DonovanSquires/KiCadDemoExercise/Exercise.odt

March 20, 2015

Copyright © 2015 Donovan Squires

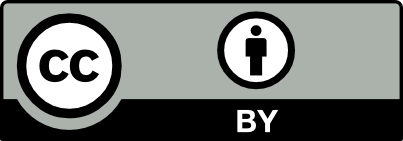
[picture p1: figure]

This work is licensed under a Creative Commons Attribution 4.0 International License (http://creativecommons.org/licenses/by/4.0/).

# Introduction

A design for an Raspberry Pi 3x3x3 LED Cube Shield has been implemented in KiCad. The completed board can be found here:

https://github.com/DonovanSquires/KiCadDemo

The project tries to illustrate several of the concepts common in a KiCad project such as:

- Project folder organization – separating library files, documentation, prints, and fabrication outputs in folders along with the project files
- Multi-sheet hierarchical organization – one root sheet with other sheets represented as hierarchical sheet symbols
- Custom schematic symbols organized in library files
- Adding parameters such as Manufacturer and Supplier part numbers to a schematic symbol to aid in bill of materials (BOM) generation
- Wires – connections between symbols that form a net
- Net labels – implied connections between two or more wires to form a net; net labels only make implied connections on a single sheet
- Ports – implied connections between a wire on a sheet and its corresponding sheet symbol
- Associating schematic symbols with PCB footprints
- Custom PCB footprints organized in library files and folders
- Two-layer PCB design
- Fulfilling predetermined mechanical requirements – lining up connectors and mounting holes of the shield board with the Raspberry Pi
- Fabrication files – generated RS274X Gerber and Excellon Drill files

To become familiar with some of the more difficult concepts in KiCad, this exercise was developed in which the four mounting holes are removed from the completed project. In this exercise you will have to draw a schematic symbol and store it in a library, add the symbols to the schematic, draw the footprint of the mounting hole and store it in a library, synchronize the schematic files with the PCB files, place the mounting hole footprints on the board, and generate fabrication files.

This document and the project files for the exercise may be found here:

https://github.com/DonovanSquires/KiCadDemoExercise

This project and exercise was developed on KiCad (2015-01-16 BZR 5376) on the Windows platform.

# Exercise

## Download and open project files

### Purpose

You will use a set of project files where most of the design has been completed except for the steps that you will perform in this exercise. The project files need to be downloaded and opened in KiCad.

### Background

The project files are stored in a GitHub repository. The repository may be downloaded as a zip file from the website, so no knowledge of git is necessary.

### Procedure

#### Navigate in a web browser to https://github.com/DonovanSquires/KiCadDemoExcercise

#### Click on the link to download a zip file of the repository

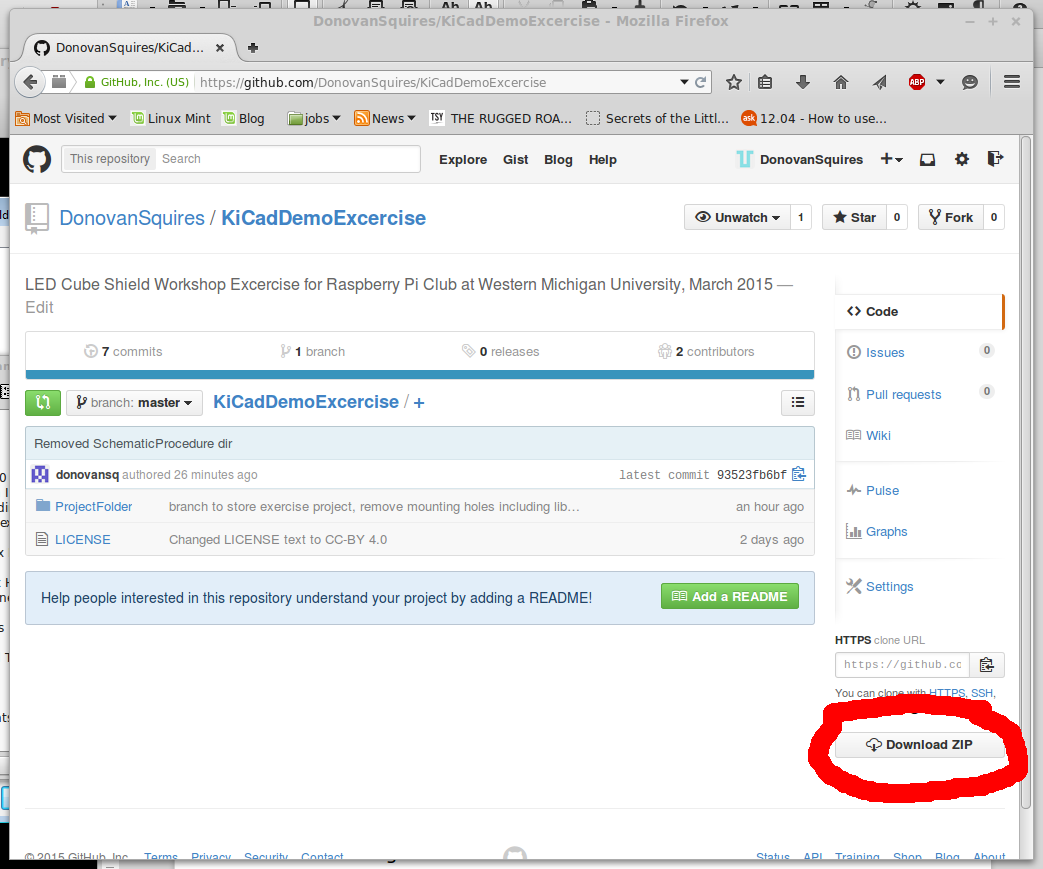
[picture p2: figure]

#### Unzip the downloaded file

#### Run KiCad and open the project file ProjectFolder\KiCadDemo.pro

## Create new schematic library

### Purpose

Create a symbol to represent a mechanical mounting hole. This symbol will be associated with a footprint that will KiCad to automatically add to the PCB.

### Background

Reusable schematic elements are store in plain text “*.lib” files. Multiple symbols may be stored in a single library file, but I prefer to make a separate library file for each symbol.

Here we will create a symbol representing a single hole that can be placed on the board and is often not electrically connected to the circuit (but it may be in some cases). Placing a symbol on the schematic allows the mounting holes to be tracked.

Pins added to symbols are used to represent an electrical connection. The schematic design rule check (DRC) can enforce rules such as not connecting two outputs to one net. I often set the pins as “Passive”, though, to avoid DRC errors that are not really applicable to the schematic.

### Procedure

#### Open Schematic Library Editor

#### Click “Create New Component” icon

#### Fill out component information

Component name: Mounting_Hole

Default reference designator: M

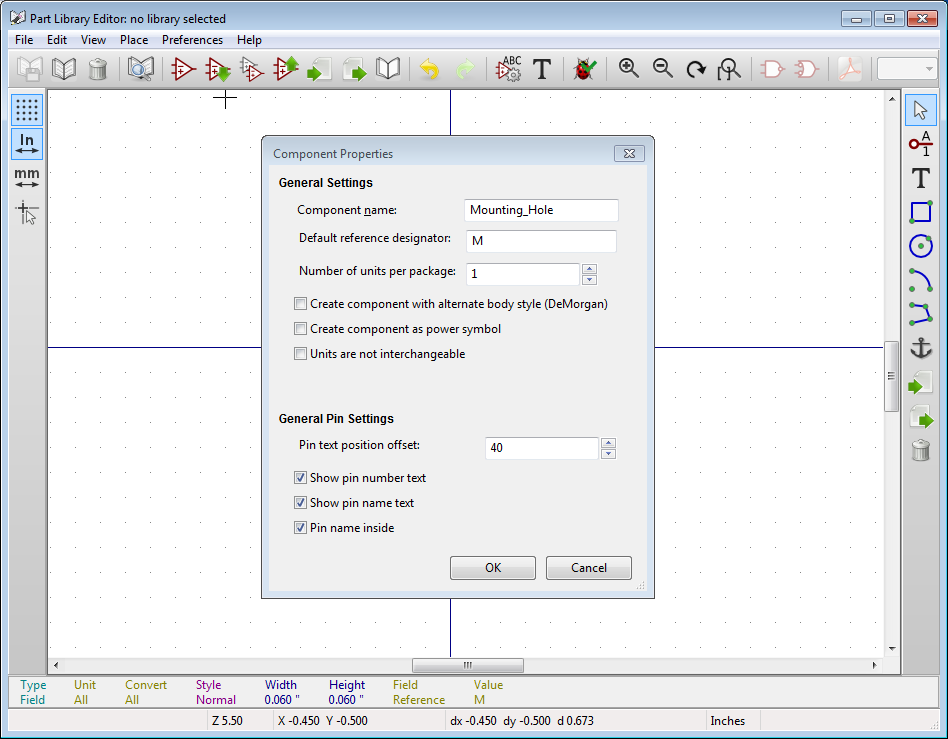
[picture p3: figure]

#### Draw symbol graphics

Draw a circle with a radius of 0.15”

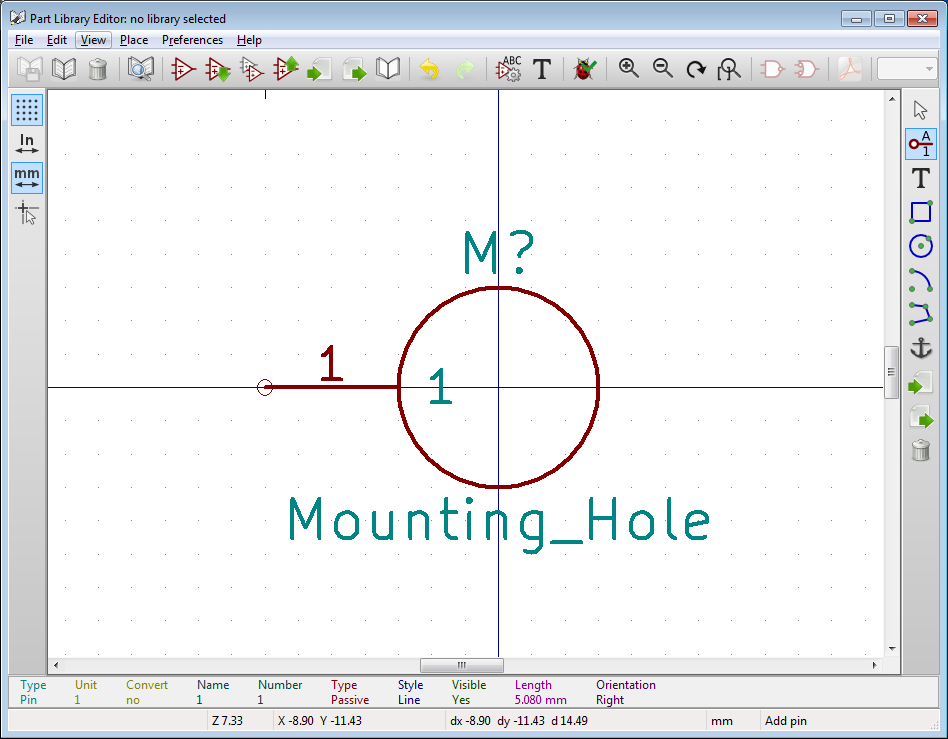
[picture p4: figure]

#### Add pin

This will allow the pad of the mounting hole to be electrically connected to the rest of the circuit if desired. Make sure that “Electrical Type” is “Passive”

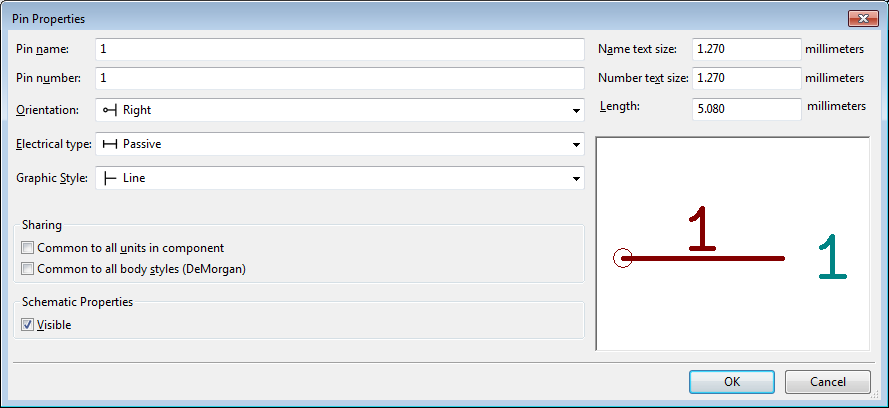
[picture p5: figure]

#### Click “Save component to new library” icon

#### Save “mounting_hole.lib” in project “lib” directory

#### Add library to project

Click “Preferences”->”Set Active Libraries”

Click “Add”

Add “lib/mounting_hole.lib”

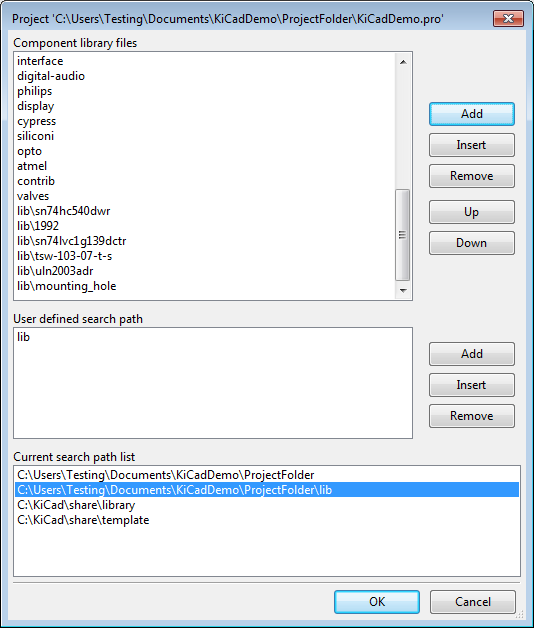
[picture p6: figure]

#### Close Schematic Library Editor

## Add components to schematic

### Purpose

Add four mounting holes symbols to the schematic that will later be associated with our desired mounting hole footprint. The schematic netlist will be updated to allow the other programs in the toolchain to read the updates to the schematic.

### Background

Components can be added from libraries. Connections can be drawn between component pins, but the mounting hole we are using will not be electrically connected on this board.

### Procedure

#### Open Eeschema

#### On the root sheet, click “Place”->”Component”

#### Click on the schematic

#### Choose “Mounting_Hole”

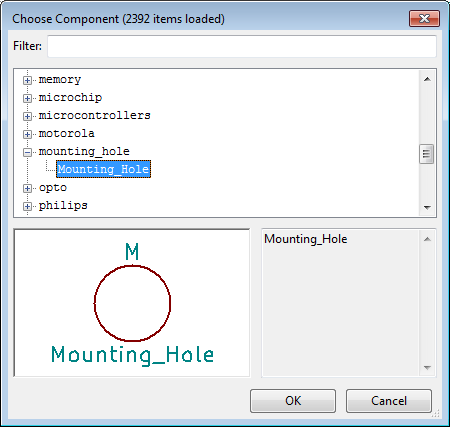
[picture p7: figure]

#### Place symbol on schematic

#### Add three more mounting hole components

You may click on the schematic again to bring up the select component dialog, or you may copy and paste the first symbol by hovering over it and pressing “c”.

#### Click “Place”->”No Connect Flag” and add flags to pins

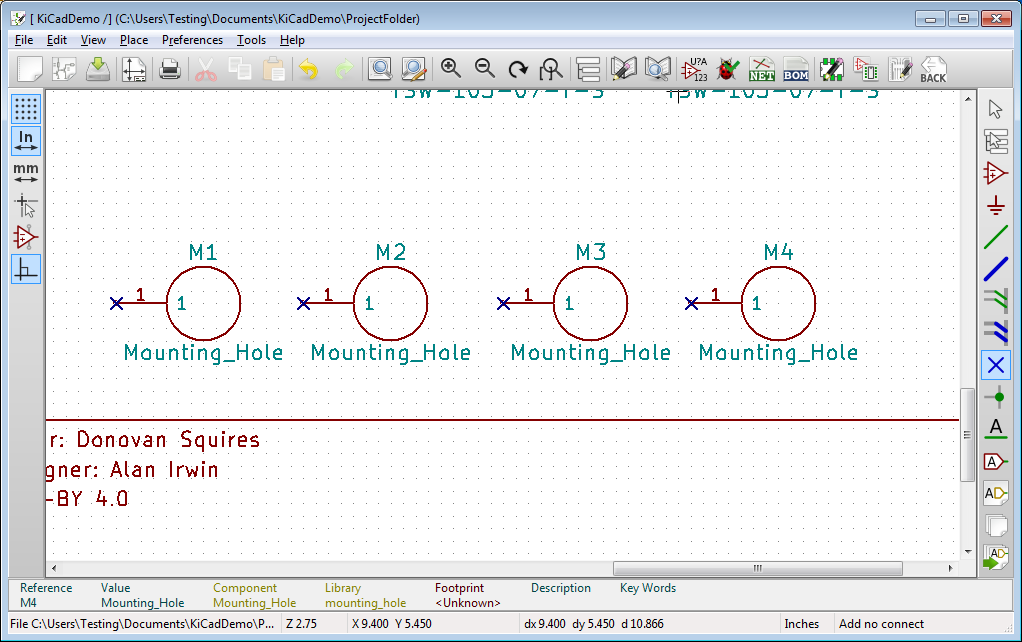
[picture p8: figure]

#### Click “Tools”->”Annotate Schematic”

This will replace the reference designators “M?” with unique numbers: “M1”. “M2”, etc. Make sure “Keep existing annotation” is selected to ensure that previously assigned designators are not re-assigned with a different number.

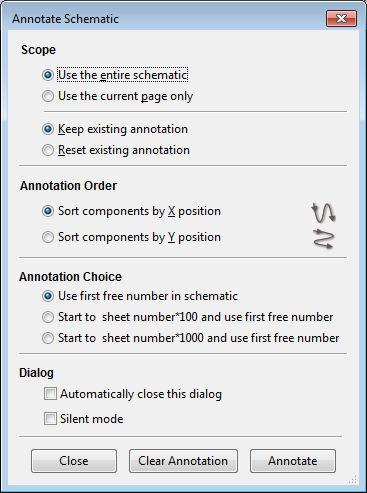
[picture p9: figure]
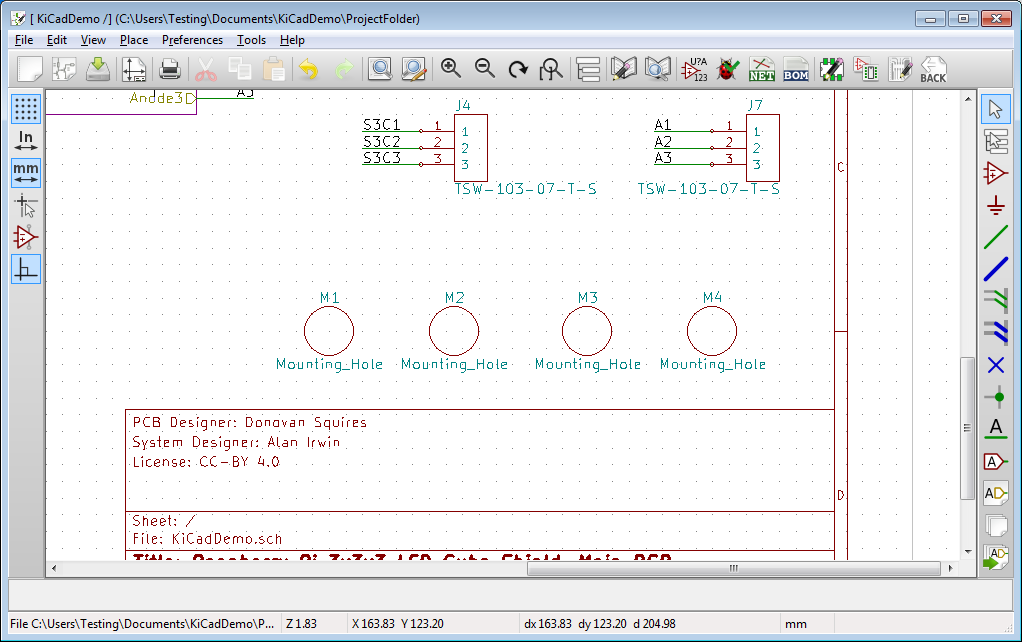
[picture p10: figure]

#### Click “Tools”->”Generate Netlist File”

In “Pcbnew” tab, click “Generate”, and overwrite the existing netlist file.

## Create new PCB footprint

### Purpose

Create a new PCB footprint library, make it accessible to Pcbnew, and create a mounting hole footprint.

### Background

A new style KiCad footprint library is a folder named “<library name>.Pretty” containing PCB footprint files “*.mod” (and 3D models and simulation models).

Pcbnew and the footprint editor need to be made aware of library locations before a footprint may be used or saved to the library. Adding to the list of available libraries is complicated. The following link explains some of the current challenges with library management: http://diy-scib.org/blog/working-kicads-terrible-library-management

This is the workflow I prefer, at the moment, for creating PCB libraires.

### Procedure

#### Create folder for PCB footprints

Using the OS's file manager, create folder “mounting_hole.Pretty” under “ProjectFolder/lib”.

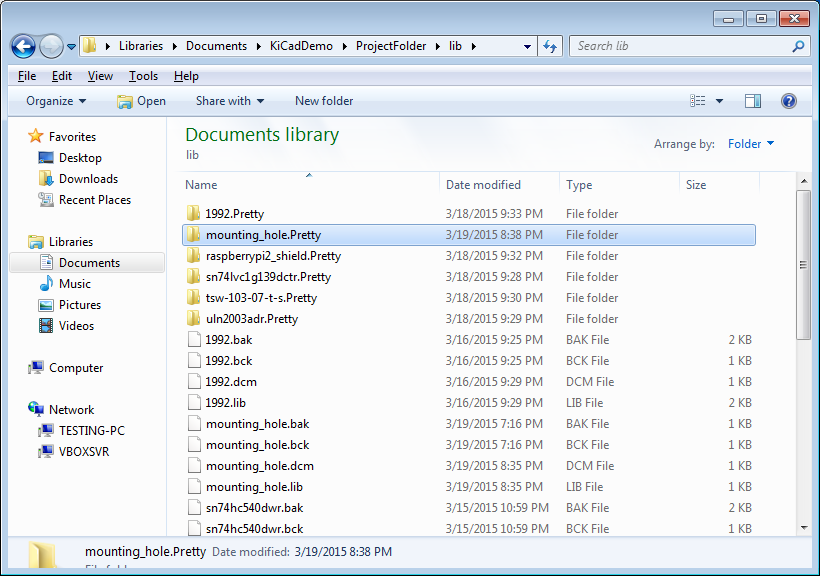
[picture p11: figure]

#### Open Pcbnew

#### Click “Preferences”->”Library Tables”

#### Add reference to PCB library

Select tab “Project Specific Libraries”, click “Append Library”, and fill out table as shown in the screenshot.

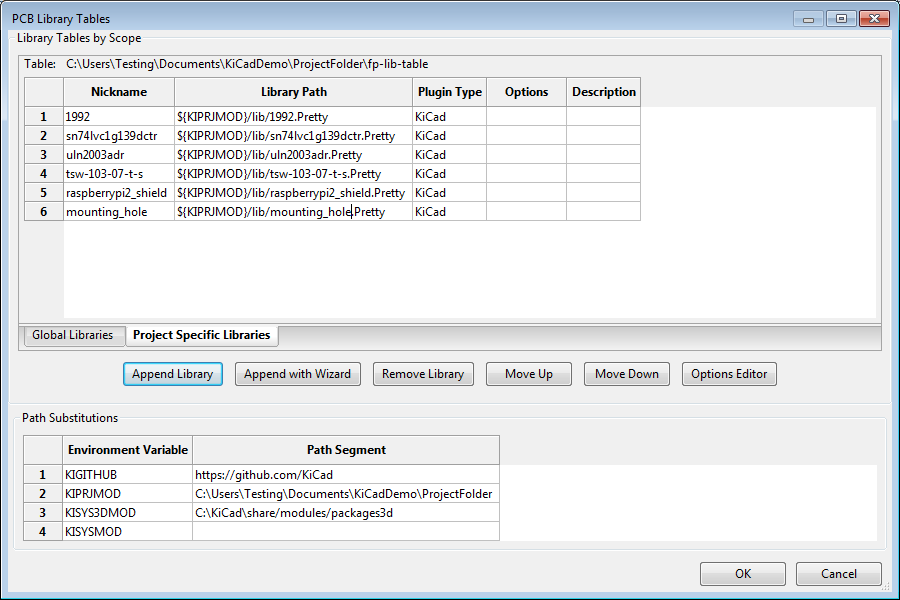
[picture p12: figure]

#### Open Footprint Editor

#### Click “Select Active Library” icon

#### Select the “mounting_hole” library (same as the nickname field from 2.4.3.4

#### Click “File”->”New Footprint”

Enter footpring name: “mounting_hole_2.75mm_pth”

pth – Plated Thru-Hole, a copper plated (mounting) hole with a copper annular ring

npth – Non-Plated Tru-Hole, an unplated (mounting) hole

#### Press “e” on text to edit “Value (VAL**)” field

Set “Display” to “Invisible”

This field, if visible, will place the text in the “Value” parameter field of the schematic symbol on the silkscreen of the board. The silkscreen can get crowded on boards, and the “Reference” text is more important: it will be replaced with the reference designator of the component.

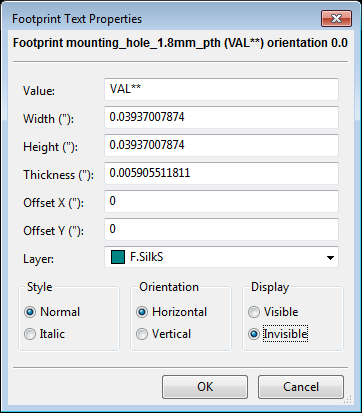
[picture p13: figure]

#### Ensure that “mm” is the selected unit

Icon is along the left side of the screen. This will let us define the pad in metric units

#### Click “Place”->”Pad”

#### Click on grid location (0,0) to place pad at origin

#### Hover over pad with cursor and press “e” to edit pad parameters

Set “Pad type” to “Through-hole” and “Circular” ans set “Size” to 4.75mm

Set “Drill” to “Circular” and 2.75mm (same diameter as mounting hole on Raspberry Pi B+/2)

Set “Pad number” to 1, this should correspond to the “Pin number” seen in section 2.2.3.5

#### Click “File”->”Save Footprint in Active Library”

#### Close footprint editor

## Associate footprint with schematic symbol

### Purpose

Tell KiCad that you want the footprint we created associated with each instance of the symbols we added to the schematic.

### Background

KiCad allows you to select a different footprint for each symbol in the schematic. This gives you flexibility in using different footprints for the same symbol. For instance, if you have a USB connector with 4 pins and a 0.1” pin header with 4 pins, you can use the same schematic symbol for both parts, but you can select the different footprints for the two components on the schematic. The program that assigns footprints is called Cvpcb.

### Procedure

#### In Schematic Editor, click “Tools”->”Assign Component Footprint”

#### Assign “mounting_hole:mounting_hole_2.75mm_pth” footprint to components M1 to M4

In the left pane, select the footprint library. In the middle plane, select one of the components from the schematic. In the right pane, double-click the name of the footprint you want to assign to the component.

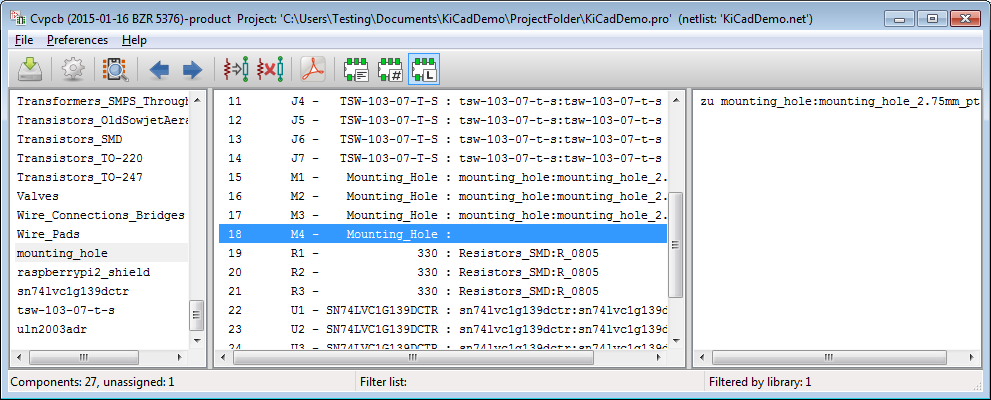
[picture p14: figure]

#### Click “File”->”Save Component File”

#### Close Cvpcb

## Import netlist in Pcbnew

### Purpose

Import the changes from the schematic editor to synchronize the components and connections

### Background

Pcbnew will ensure that all of the symbols in the schematic have their associated components on the board, and Pcbnew will keep track of which pins need to be electrically connected or not connected, according to the schematic drawing.

When you make any changes to the schematic, the changes must be imported into Pcbnew.

### Procedure

#### In Pcbnew, click “Tools”->”Netlist”

#### Click “Read Current Netlist” and “Rebuild Board Connectivity”

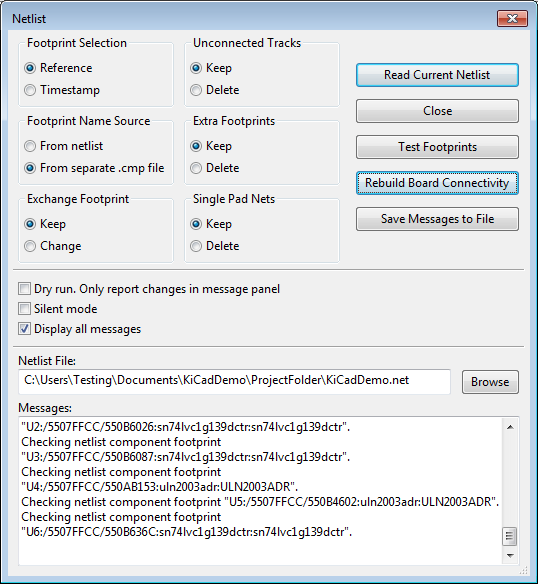
[picture p15: figure]

#### Notice the mounting holes are placed in the PCB editor, but they are all placed at the same location, on top of each other

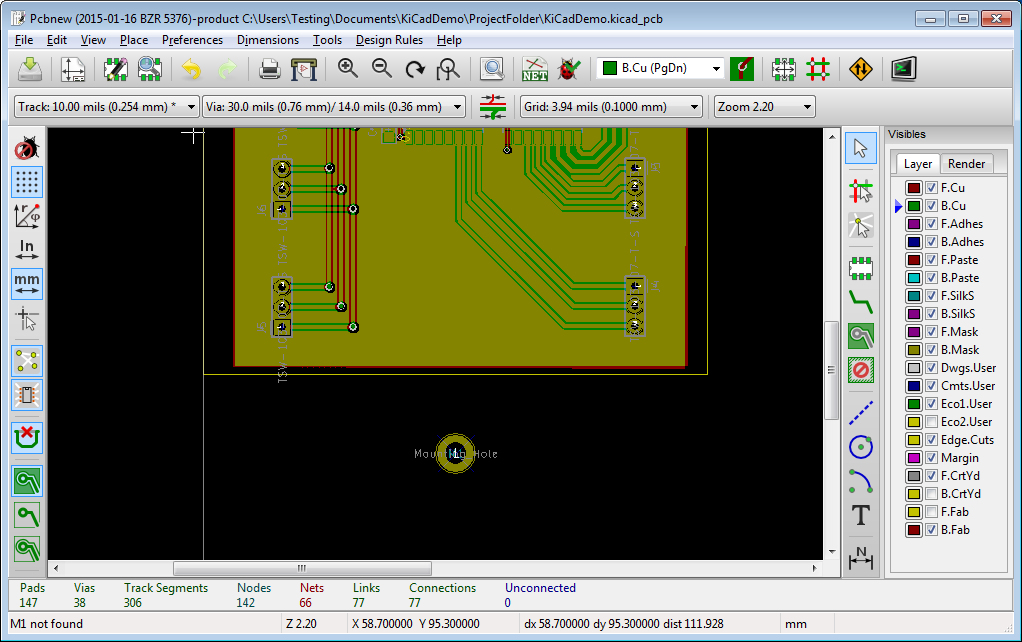
[picture p16: figure]

## Place components

### Purpose

The imported changes from the schematic are not placed intelligently. Components need to be moved so they are not on top of each other, and they need to be placed in the required location on the board.

### Background

Pcbnew can move the components so they are easier to grab and move. We will have to place the mounting holes in the location that we need, which will correspond to the mounting hole locations on the Raspberry Pi B+/2

### Procedure

#### In Pcbnew, set zones to “do not show filled zones”

This will make the board easier to see.

#### Click the “Mode footprint: [...]” icon

This will make the options we need available in the right-click menu.

#### Right-click anywhere on the board

#### Select “Global Spread and Place”->”Spread out footprints not already on board”

If this was a new board, you can select “Spread out all footprints”

Result:

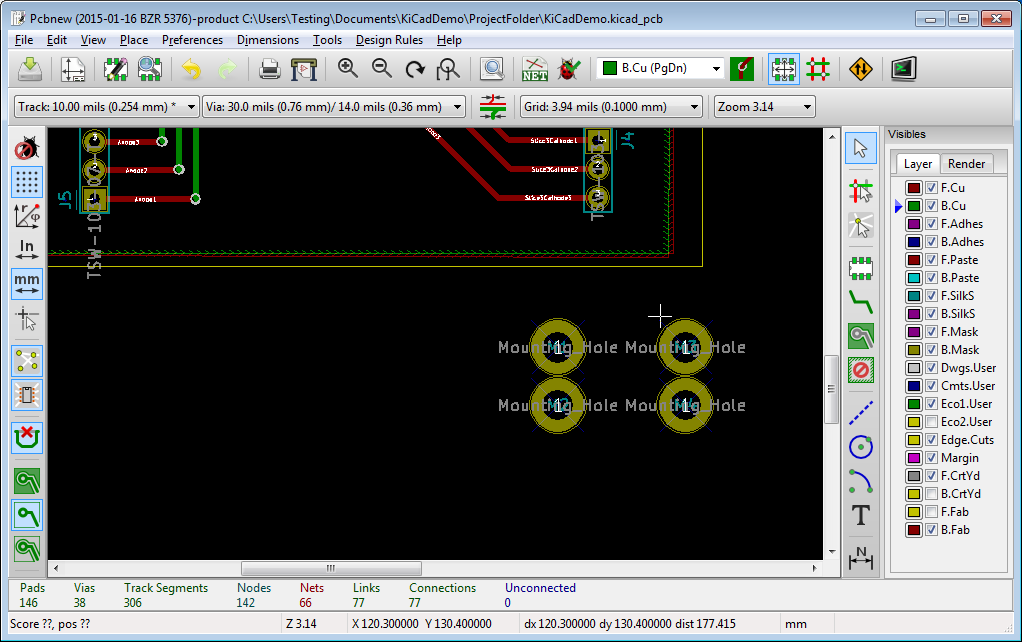
[picture p17: figure]

#### Enable visibility on F.Fab layer

I placed a schematic footprint that uses this layer to draw an outline of the Raspberry Pi with its connector and mounting holes.

#### Place mounting holes at the same locations as the Pi holes

You can try to place them manually, or you can press “e” over the footprint and type the “X” and “Y” position for a more accurate result

#### Right-click on edge of zones on front and bottom copper

For each zone, select “Zone Outline”->”Zones”->”Fill Zone”.

This makes the zone not intersect with the new component.

Zones are a.k.a. copper pours or copper planes or regions in other CAD packages.

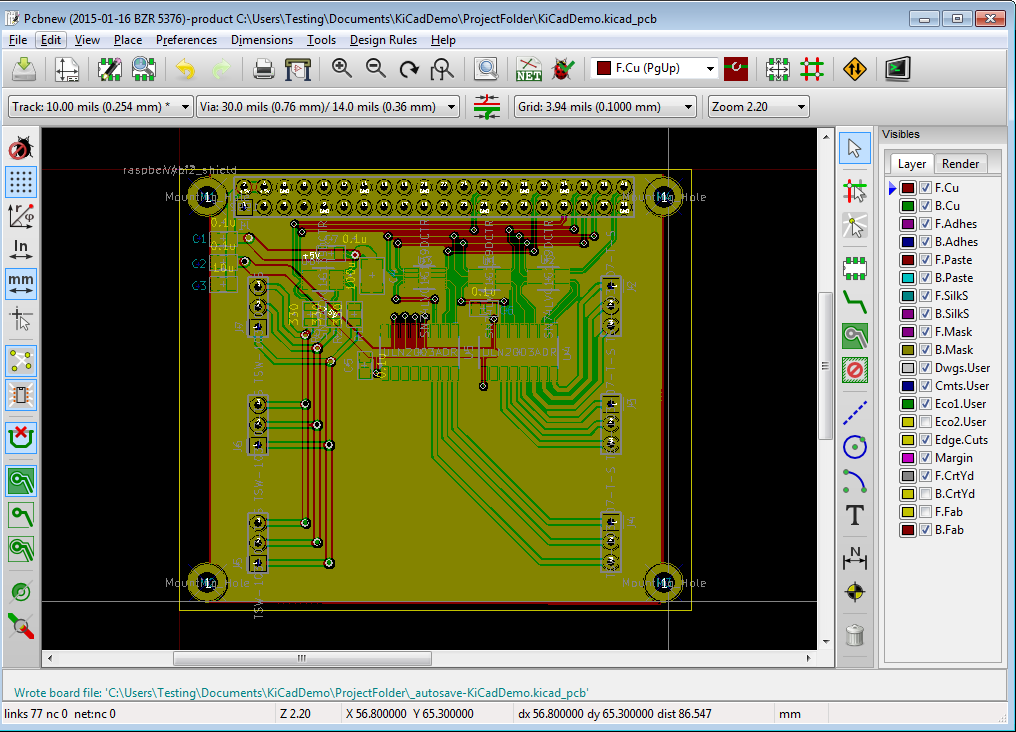
[picture p18: figure]

#### Select “Tools”->”DRC”

#### Click “Start DRC” then “List Unconnected”

This will check to make sure that pads and nets aren't connected in a way that conflicts with the netlist.

## Generate Gerbers

### Purpose

Produce fabrication files for a board manufacturer

### Background

Most manufacturers accept a standard text format for defining the board. Gerber RS-274X is the most common standard, which KiCad outputs by default when you select a Gerber output. To define the drill holes, Excellon Drill files are the standard most used.

Each layer and the drill file are stored in separate files.

This version of KiCad (2015-01-16 BZR 5376) appears to only output Gerbers in metric format, whereas, most manufacturers specify imperial format (inches). The Excellon Drill file should probably be output as metric to be consistent with the Gerber files.

### Procedure

#### In Pcbnew, click “File”->”Plot”

#### Fill out the window as below and click “Plot”

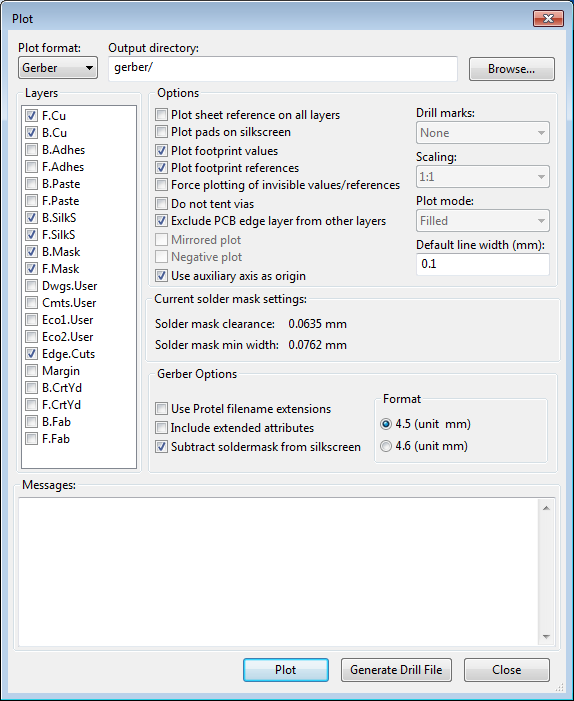
[picture p19: figure]

#### In the “Plot” window, select “Generate Drill File”

#### Fill out the window as below and click “Drill File”

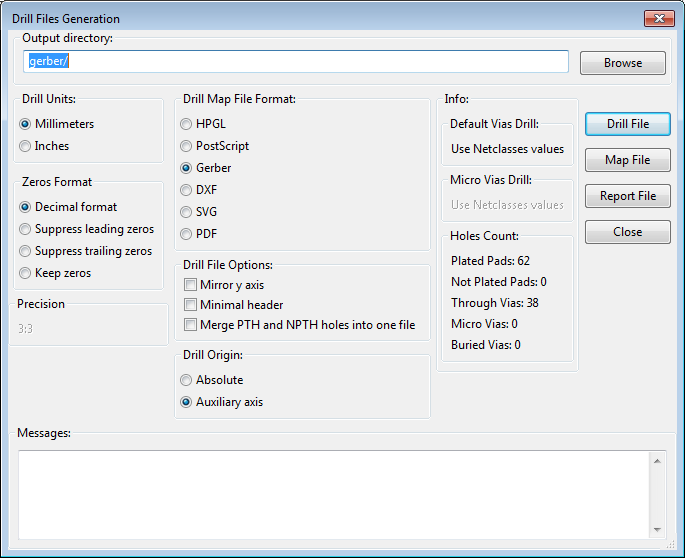
[picture p20: figure]

#### Fabrication files have been created

You can close windows and exit KiCad. It's good to verify the gerber files are what you expect with a gerber viewer, such as the one included in KiCad or a 3rd party software.

# Appendix

## User trace and via bug

When you open a PCB file, the user made track widths and via sizes will not be available. Open the “Design Rules”->”Design Rules” dialog, and the user tracks and vias will be available again.

Copyright © 2015 Donovan Squires
