DonovanSquires/KiCadDemoExercise/ProjectFolder/print/KiCadDemoSchematic.pdf

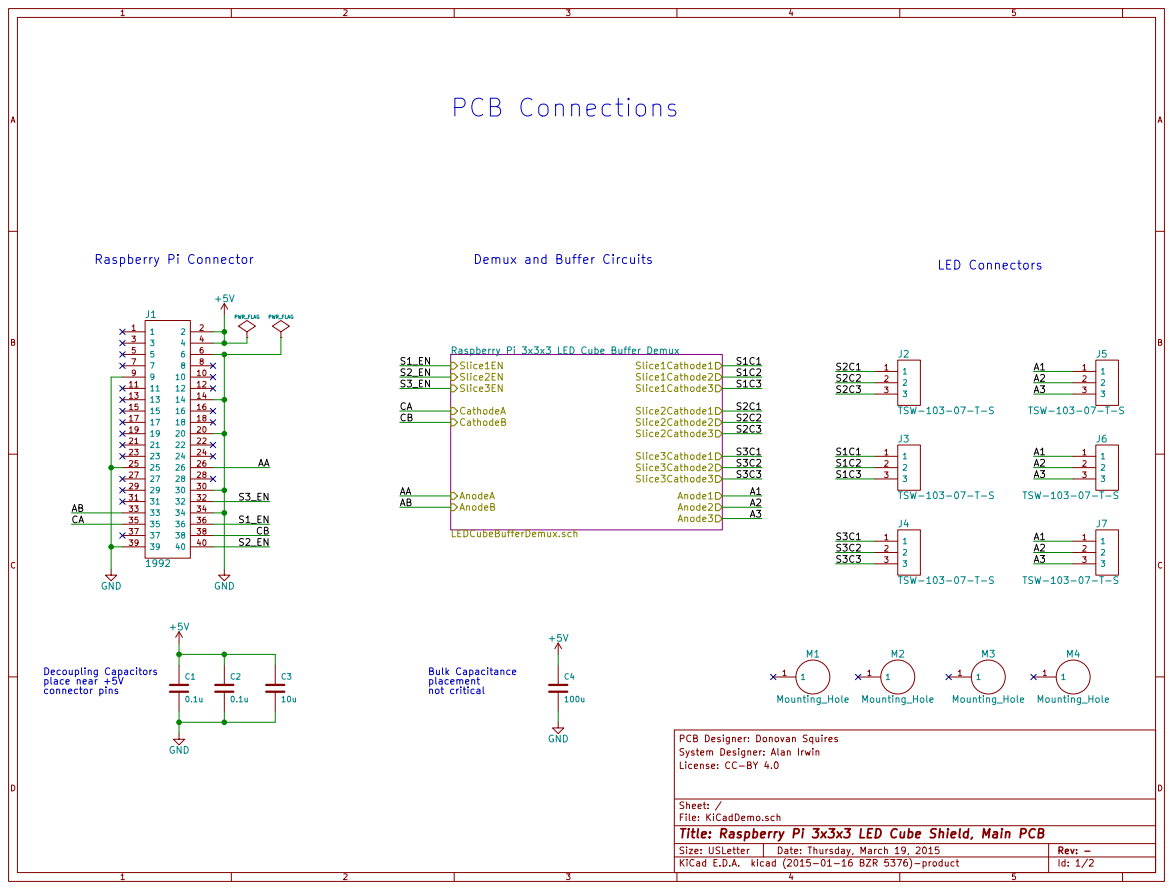
[picture p21: page 1]

PCB Designer: Donovan Squires
File: KiCadDemo.sch Sheet: / License: CC-BY 4.0 System Designer: Alan Irwin

Id: 1/2 Title: Raspberry Pi 3x3x3 LED Cube Shield, Main PCB

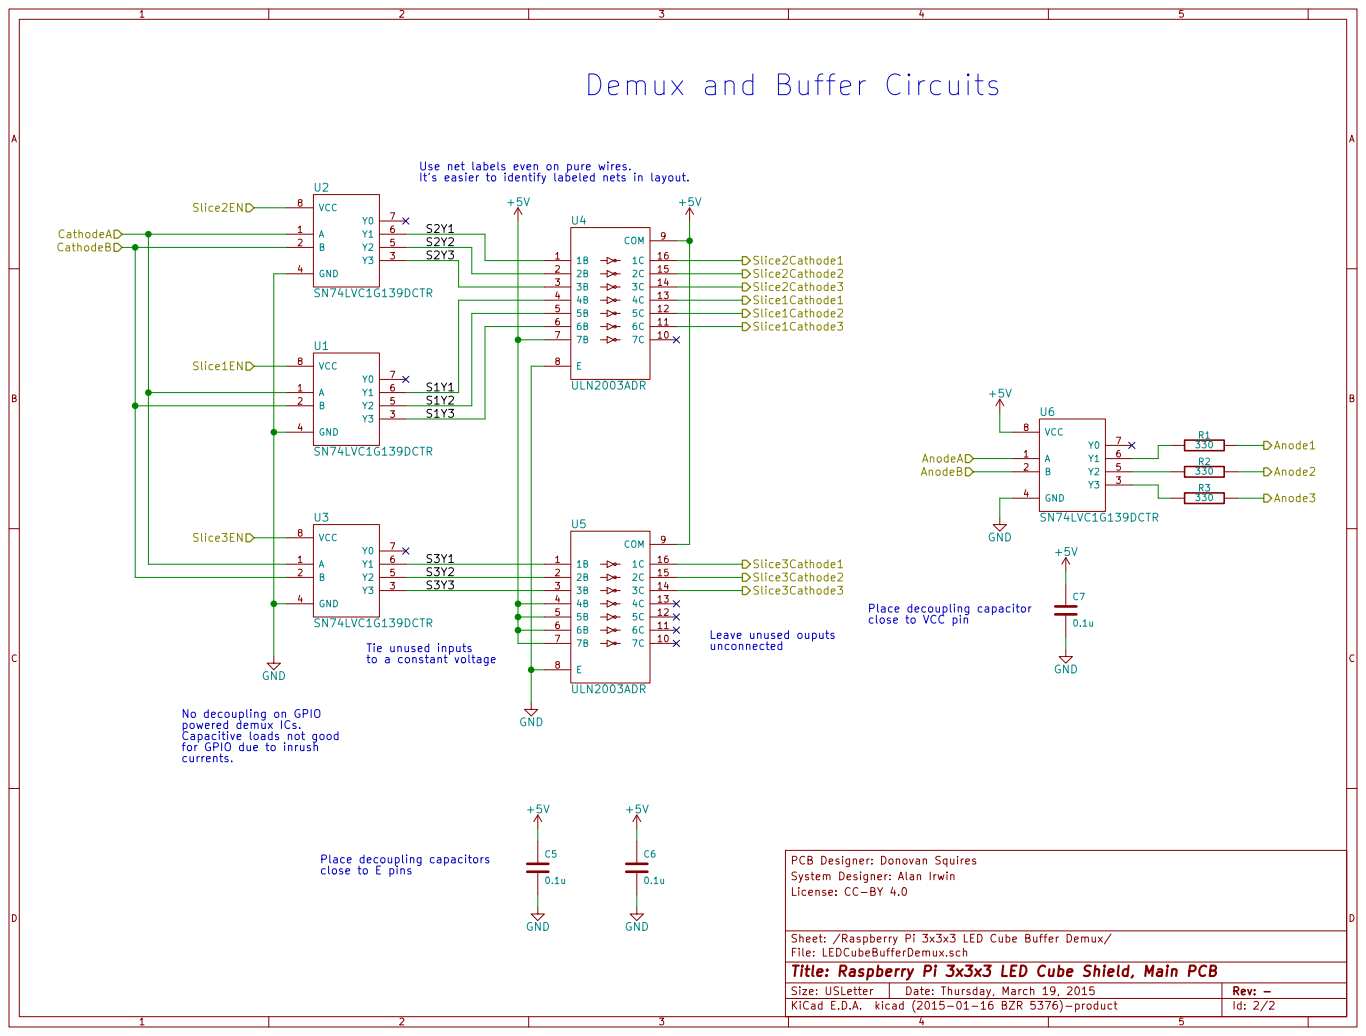
[picture p22: page 2]

Demux and Buffer Circuits

Use net labels even on pure wires.
It's easier to identify labeled nets in layout.

5B 5
6B 6

S3Y2 | 2B 2
S3Y3 | 3B 3

4B 4

Place decoupling capacitor
close to VCC pin

No decoupling on GPIO
powered demux ICs.
Capacitive loads not good
for GPIO due to inrush
currents.

PCB Designer: Donovan Squires
File: LEDCubeBufferDemux.sch Sheet: /Raspberry Pi 3x3x3 LED Cube Buffer Demux/ License: CC-BY 4.0 System Designer: Alan Irwin

Id: 2/2 Title: Raspberry Pi 3x3x3 LED Cube Shield, Main PCB
