DonovanSquires/KiCadDemoExercise/ProjectFolder/doc/raspberry-pi-3x3x3-led-cube-shield.pdf

# Cathode/Ground Control

# Anode/VCC Control

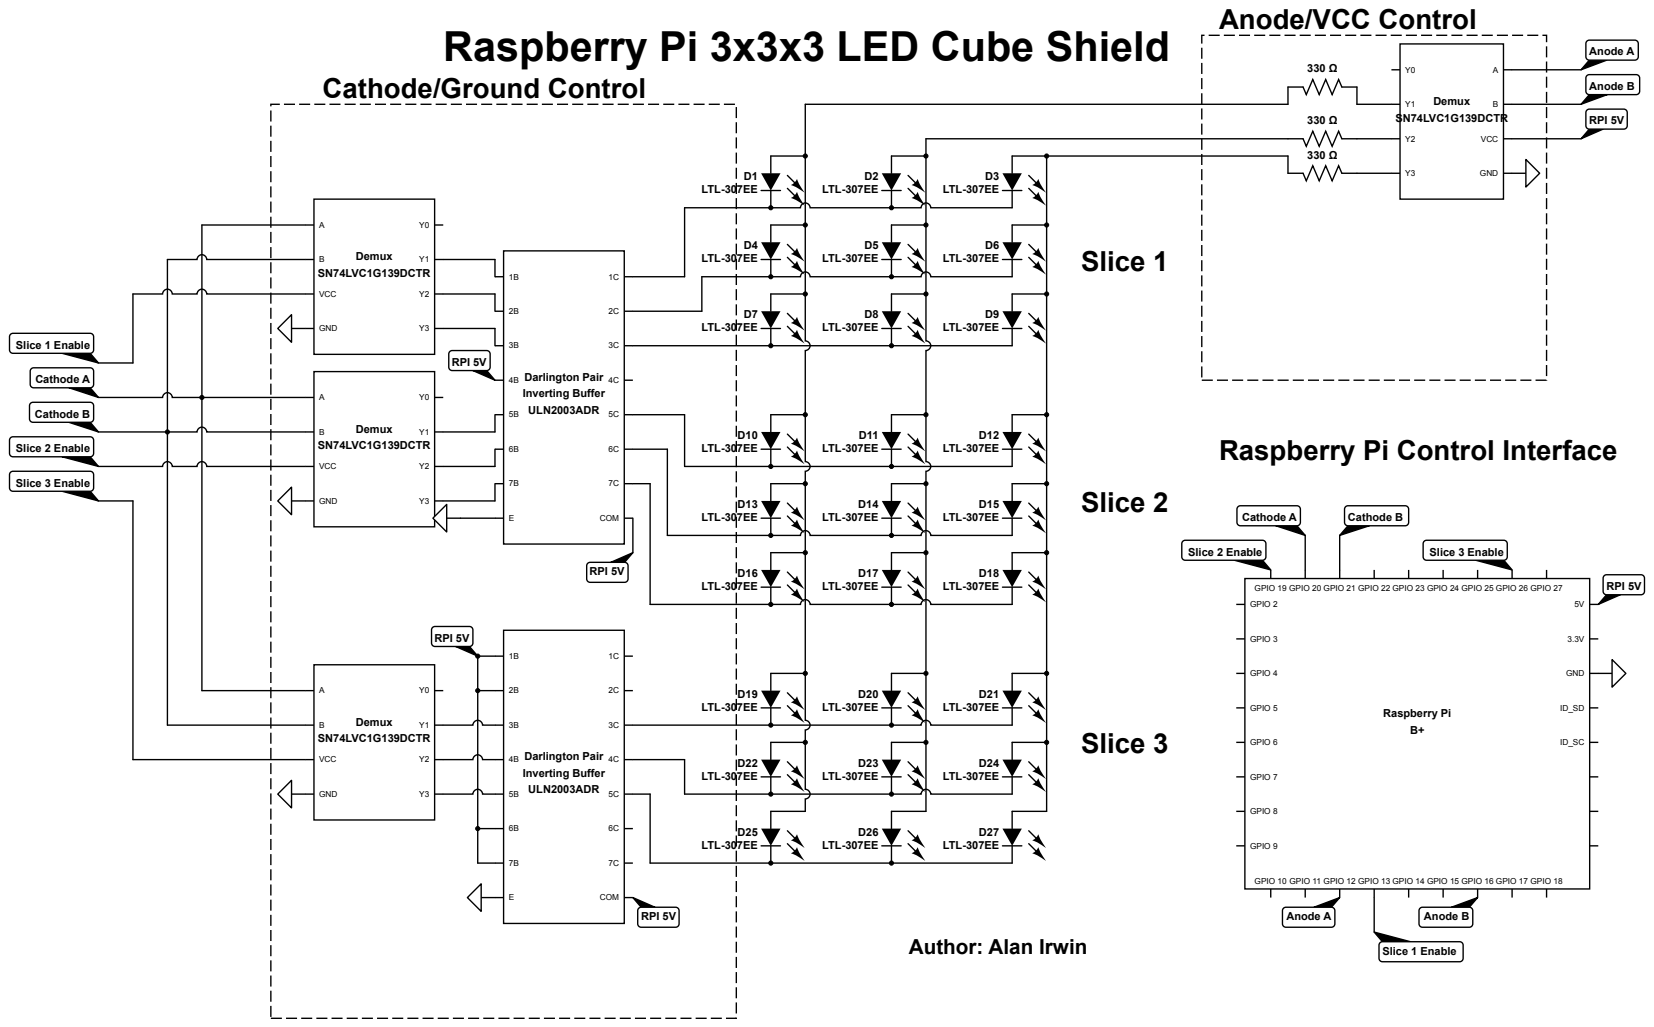
[picture p23: page 1]

Raspberry Pi 3x3x3 LED Cube Shield

Raspberry Pi Control Interface

GPIO 19 GPIO 20 GPIO 21 GPIO 22 GPIO 23 GPIO 24 GPIO 25 GPIO 26 GPIO 27

GPIO 10 GPIO 11 GPIO 12 GPIO 13 GPIO 14 GPIO 15 GPIO 16 GPIO 17 GPIO 18
