DonovanSquires/KiCadDemoExercise/ProjectFolder/print/KiCadDemoPCB.pdf

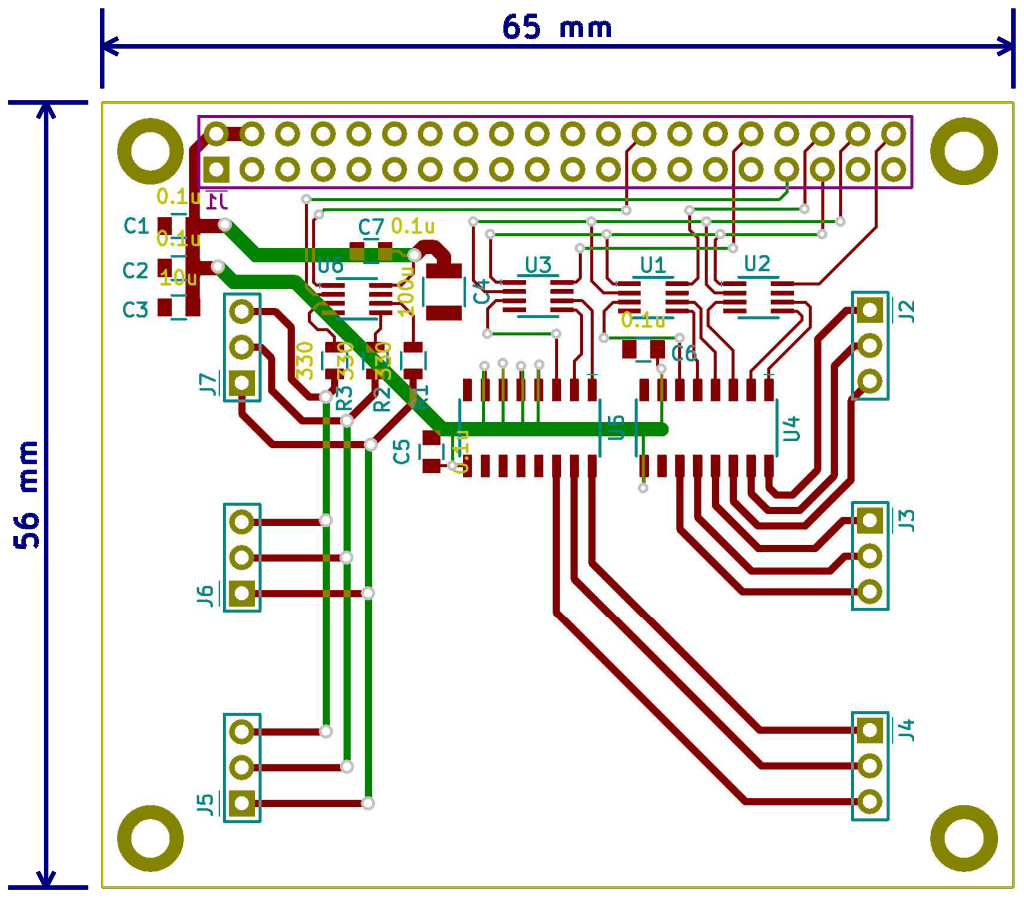
[picture p24: page 1]
