DonovanSquires/KiCadDemoExercise/ProjectFolder/KiCadDemo.kicad_pcb

## KiCad design ProjectFolder/KiCadDemo.kicad_pcb (2015-03-20)

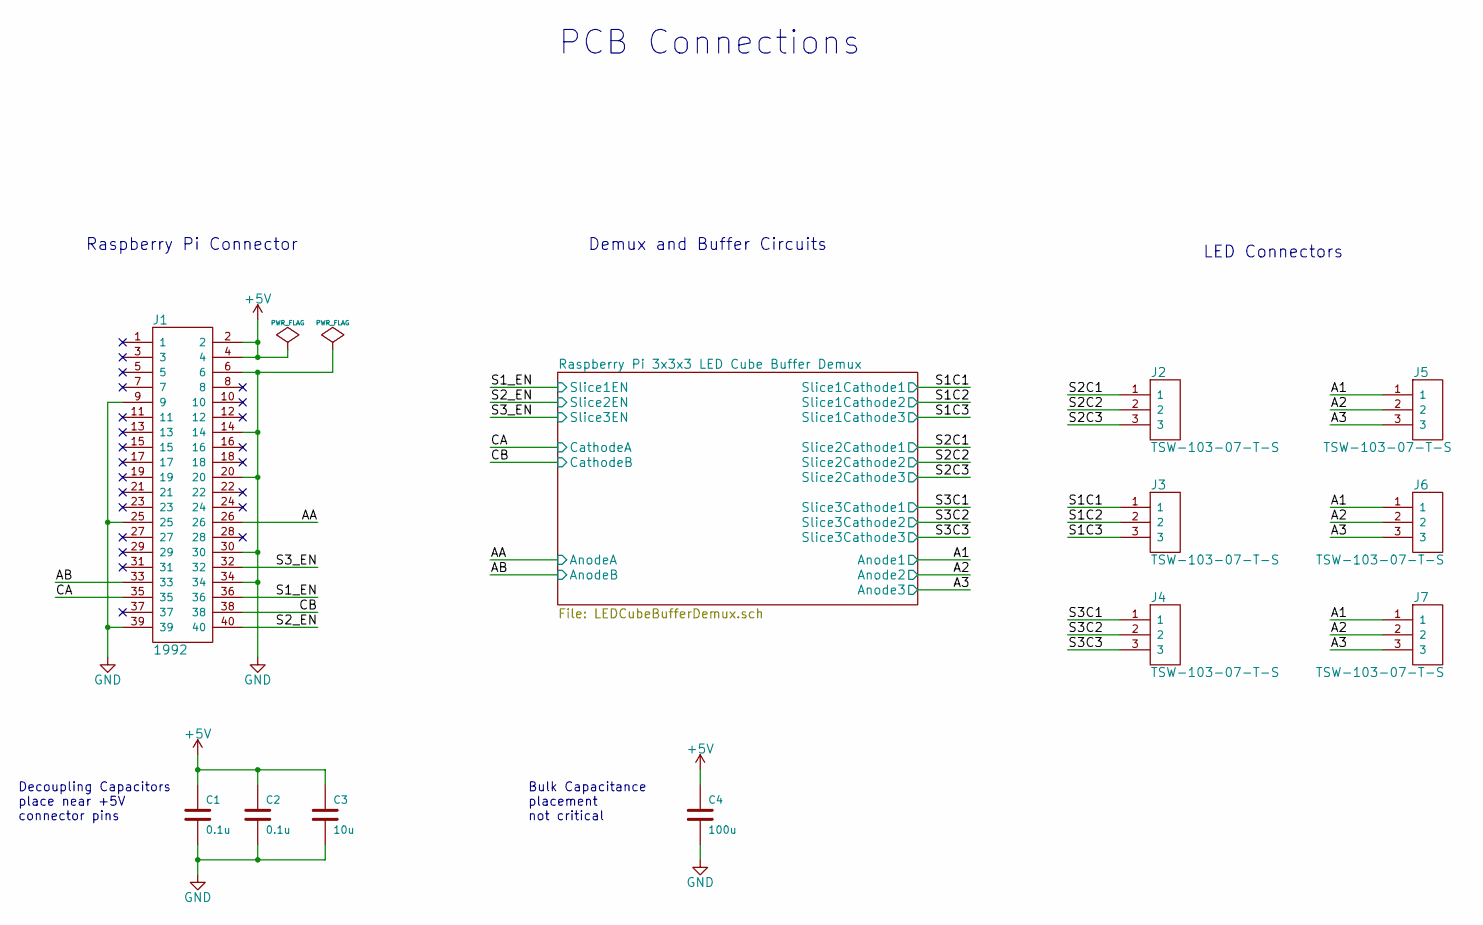
[picture p25: schematic KiCadDemo.sch, Raspberry Pi 3x3x3 LED Cube Shield, Main PCB]

Parts:
C1, C2: 0.1u; C_0805; Voltage 16V; Manufacturer Part Number C0805C104K4RACTU
C3: 10u; C_0805; Voltage 16V; Manufacturer Part Number GRM21BR61C106KE15L
C4: 100u; C_1210; Voltage 6.3V; Manufacturer Part Number GRM32ER60J107ME20L
J1: 1992; Manufacturer Part Number Unknown
J2, J3, J4, J5, J6, J7: TSW-103-07-T-S; tsw-103-07-t-s; Manufacturer Part Number TSW-103-07-T-S

Connections:
+5V: C1.1, C2.1, C3.1, C4.1, J1.2, J1.4; also elsewhere on the board
/Raspberry Pi 3x3x3 LED Cube Buffer Demux/Anode1: J5.1, J6.1, J7.1; also elsewhere on the board
/Raspberry Pi 3x3x3 LED Cube Buffer Demux/Anode2: J5.2, J6.2, J7.2; also elsewhere on the board
/Raspberry Pi 3x3x3 LED Cube Buffer Demux/Anode3: J5.3, J6.3, J7.3; also elsewhere on the board
/Raspberry Pi 3x3x3 LED Cube Buffer Demux/AnodeA: J1.26; also elsewhere on the board
/Raspberry Pi 3x3x3 LED Cube Buffer Demux/AnodeB: J1.33; also elsewhere on the board
/Raspberry Pi 3x3x3 LED Cube Buffer Demux/CathodeA: J1.35; also elsewhere on the board
/Raspberry Pi 3x3x3 LED Cube Buffer Demux/CathodeB: J1.38; also elsewhere on the board
/Raspberry Pi 3x3x3 LED Cube Buffer Demux/Slice1Cathode1: J3.1; also elsewhere on the board
/Raspberry Pi 3x3x3 LED Cube Buffer Demux/Slice1Cathode2: J3.2; also elsewhere on the board
/Raspberry Pi 3x3x3 LED Cube Buffer Demux/Slice1Cathode3: J3.3; also elsewhere on the board
/Raspberry Pi 3x3x3 LED Cube Buffer Demux/Slice1EN: J1.36; also elsewhere on the board
/Raspberry Pi 3x3x3 LED Cube Buffer Demux/Slice2Cathode1: J2.1; also elsewhere on the board
/Raspberry Pi 3x3x3 LED Cube Buffer Demux/Slice2Cathode2: J2.2; also elsewhere on the board
/Raspberry Pi 3x3x3 LED Cube Buffer Demux/Slice2Cathode3: J2.3; also elsewhere on the board
/Raspberry Pi 3x3x3 LED Cube Buffer Demux/Slice2EN: J1.40; also elsewhere on the board
/Raspberry Pi 3x3x3 LED Cube Buffer Demux/Slice3Cathode1: J4.1; also elsewhere on the board
/Raspberry Pi 3x3x3 LED Cube Buffer Demux/Slice3Cathode2: J4.2; also elsewhere on the board
/Raspberry Pi 3x3x3 LED Cube Buffer Demux/Slice3Cathode3: J4.3; also elsewhere on the board
/Raspberry Pi 3x3x3 LED Cube Buffer Demux/Slice3EN: J1.32; also elsewhere on the board
GND: C1.2, C2.2, C3.2, C4.2, J1.6, J1.9, J1.14, J1.20, J1.25, J1.30, J1.34, J1.39; also elsewhere on the board

Notes on the sheet:
Raspberry Pi Connector
Demux and Buffer Circuits
LED Connectors
PCB Connections
Decoupling Capacitors place near +5V connector pins
Bulk Capacitance placement not critical

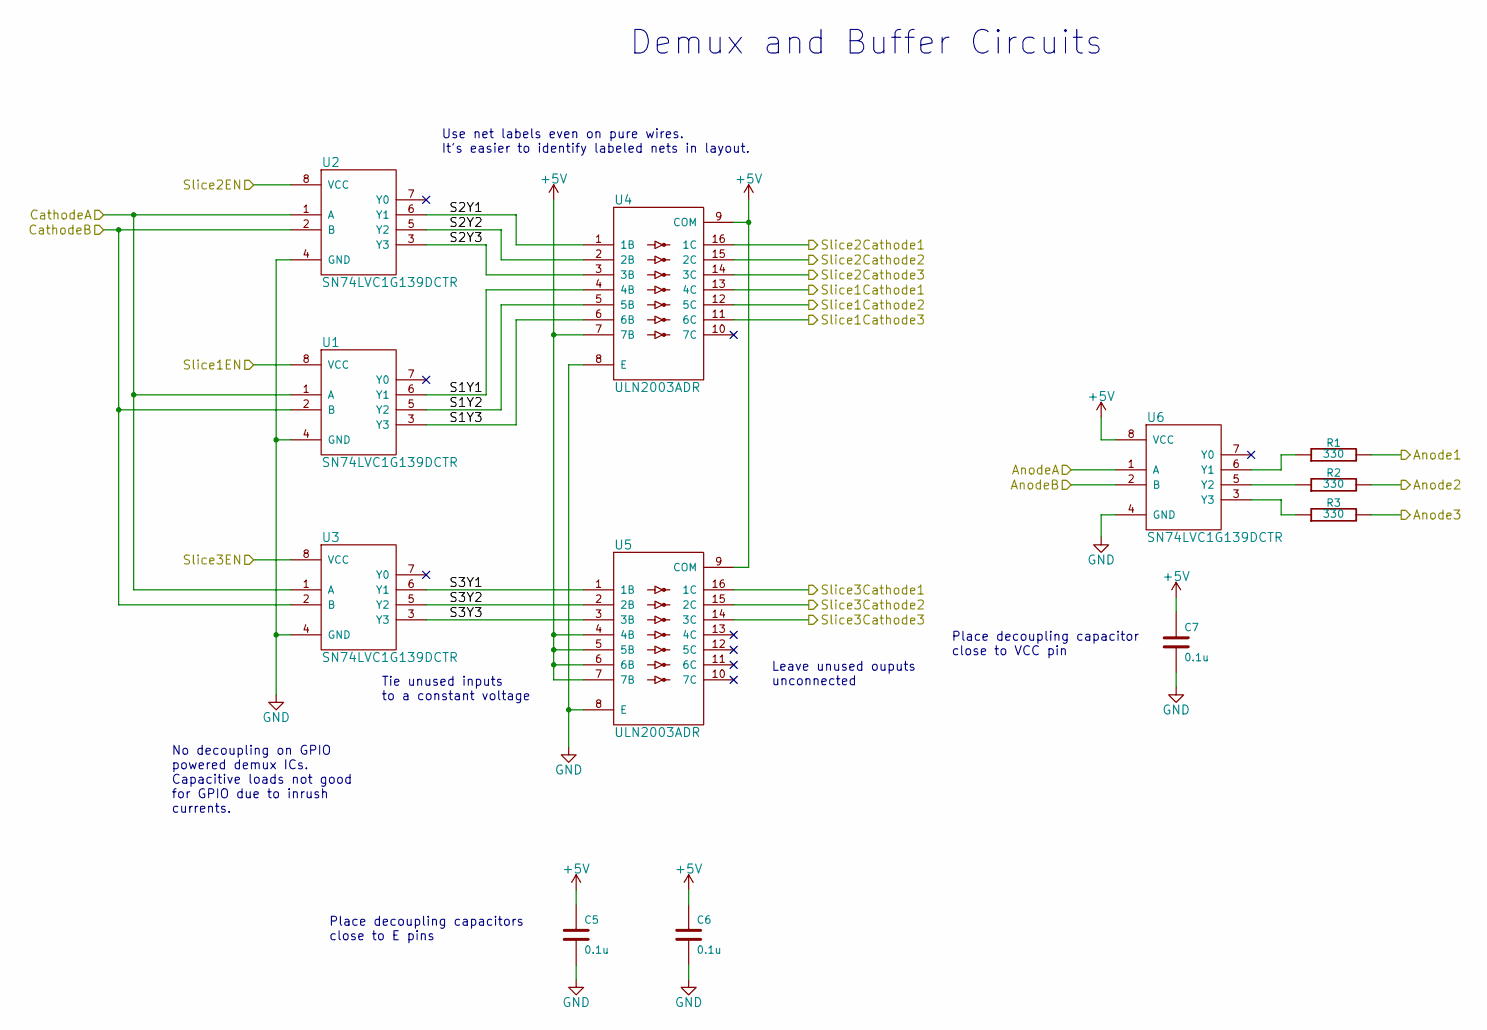
[picture p26: schematic LEDCubeBufferDemux.sch, Raspberry Pi 3x3x3 LED Cube Shield, Main PCB]

Parts:
C5, C6, C7: 0.1u; C_0805; Voltage 16V; Manufacturer Part Number C0805C104K4RACTU
R1, R2, R3: 330; R_0805; Tolerance 5%; Manufacturer Part Number ERJ-6GEYJ331V
U1, U2, U3, U6: SN74LVC1G139DCTR; sn74lvc1g139dctr; Manufacturer Part Number SN74LVC1G139DCTR
U4, U5: ULN2003ADR; Manufacturer Part Number ULN2003ADR

Connections:
+5V: C5.1, C6.1, C7.1, U4.7 (7B), U4.9 (COM), U5.4 (4B), U5.5 (5B), U5.6 (6B), U5.7 (7B), U5.9 (COM), U6.8 (VCC); also elsewhere on the board
/Raspberry Pi 3x3x3 LED Cube Buffer Demux/Anode1: R1.2; also elsewhere on the board
/Raspberry Pi 3x3x3 LED Cube Buffer Demux/Anode2: R2.2; also elsewhere on the board
/Raspberry Pi 3x3x3 LED Cube Buffer Demux/Anode3: R3.2; also elsewhere on the board
/Raspberry Pi 3x3x3 LED Cube Buffer Demux/AnodeA: U6.1 (A); also elsewhere on the board
/Raspberry Pi 3x3x3 LED Cube Buffer Demux/AnodeB: U6.2 (B); also elsewhere on the board
/Raspberry Pi 3x3x3 LED Cube Buffer Demux/CathodeA: U1.1 (A), U2.1 (A), U3.1 (A); also elsewhere on the board
/Raspberry Pi 3x3x3 LED Cube Buffer Demux/CathodeB: U1.2 (B), U2.2 (B), U3.2 (B); also elsewhere on the board
/Raspberry Pi 3x3x3 LED Cube Buffer Demux/S1Y1: U1.6 (Y1), U4.4 (4B)
/Raspberry Pi 3x3x3 LED Cube Buffer Demux/S1Y2: U1.5 (Y2), U4.5 (5B)
/Raspberry Pi 3x3x3 LED Cube Buffer Demux/S1Y3: U1.3 (Y3), U4.6 (6B)
/Raspberry Pi 3x3x3 LED Cube Buffer Demux/S2Y1: U2.6 (Y1), U4.1 (1B)
/Raspberry Pi 3x3x3 LED Cube Buffer Demux/S2Y2: U2.5 (Y2), U4.2 (2B)
/Raspberry Pi 3x3x3 LED Cube Buffer Demux/S2Y3: U2.3 (Y3), U4.3 (3B)
/Raspberry Pi 3x3x3 LED Cube Buffer Demux/S3Y1: U3.6 (Y1), U5.1 (1B)
/Raspberry Pi 3x3x3 LED Cube Buffer Demux/S3Y2: U3.5 (Y2), U5.2 (2B)
/Raspberry Pi 3x3x3 LED Cube Buffer Demux/S3Y3: U3.3 (Y3), U5.3 (3B)
/Raspberry Pi 3x3x3 LED Cube Buffer Demux/Slice1Cathode1: U4.13 (4C); also elsewhere on the board
/Raspberry Pi 3x3x3 LED Cube Buffer Demux/Slice1Cathode2: U4.12 (5C); also elsewhere on the board
/Raspberry Pi 3x3x3 LED Cube Buffer Demux/Slice1Cathode3: U4.11 (6C); also elsewhere on the board
/Raspberry Pi 3x3x3 LED Cube Buffer Demux/Slice1EN: U1.8 (VCC); also elsewhere on the board
/Raspberry Pi 3x3x3 LED Cube Buffer Demux/Slice2Cathode1: U4.16 (1C); also elsewhere on the board
/Raspberry Pi 3x3x3 LED Cube Buffer Demux/Slice2Cathode2: U4.15 (2C); also elsewhere on the board
/Raspberry Pi 3x3x3 LED Cube Buffer Demux/Slice2Cathode3: U4.14 (3C); also elsewhere on the board
/Raspberry Pi 3x3x3 LED Cube Buffer Demux/Slice2EN: U2.8 (VCC); also elsewhere on the board
/Raspberry Pi 3x3x3 LED Cube Buffer Demux/Slice3Cathode1: U5.16 (1C); also elsewhere on the board
/Raspberry Pi 3x3x3 LED Cube Buffer Demux/Slice3Cathode2: U5.15 (2C); also elsewhere on the board
/Raspberry Pi 3x3x3 LED Cube Buffer Demux/Slice3Cathode3: U5.14 (3C); also elsewhere on the board
/Raspberry Pi 3x3x3 LED Cube Buffer Demux/Slice3EN: U3.8 (VCC); also elsewhere on the board
GND: C5.2, C6.2, C7.2, U1.4 (GND), U2.4 (GND), U3.4 (GND), U4.8 (E), U5.8 (E), U6.4 (GND); also elsewhere on the board
unnamed: R1.1, U6.6 (Y1)
unnamed: R2.1, U6.5 (Y2)
unnamed: R3.1, U6.3 (Y3)

Notes on the sheet:
Demux and Buffer Circuits
Tie unused inputs to a constant voltage
Leave unused ouputs unconnected
Place decoupling capacitors close to E pins
Use net labels even on pure wires. It's easier to identify labeled nets in layout.
No decoupling on GPIO powered demux ICs. Capacitive loads not good for GPIO due to inrush currents.
Place decoupling capacitor close to VCC pin

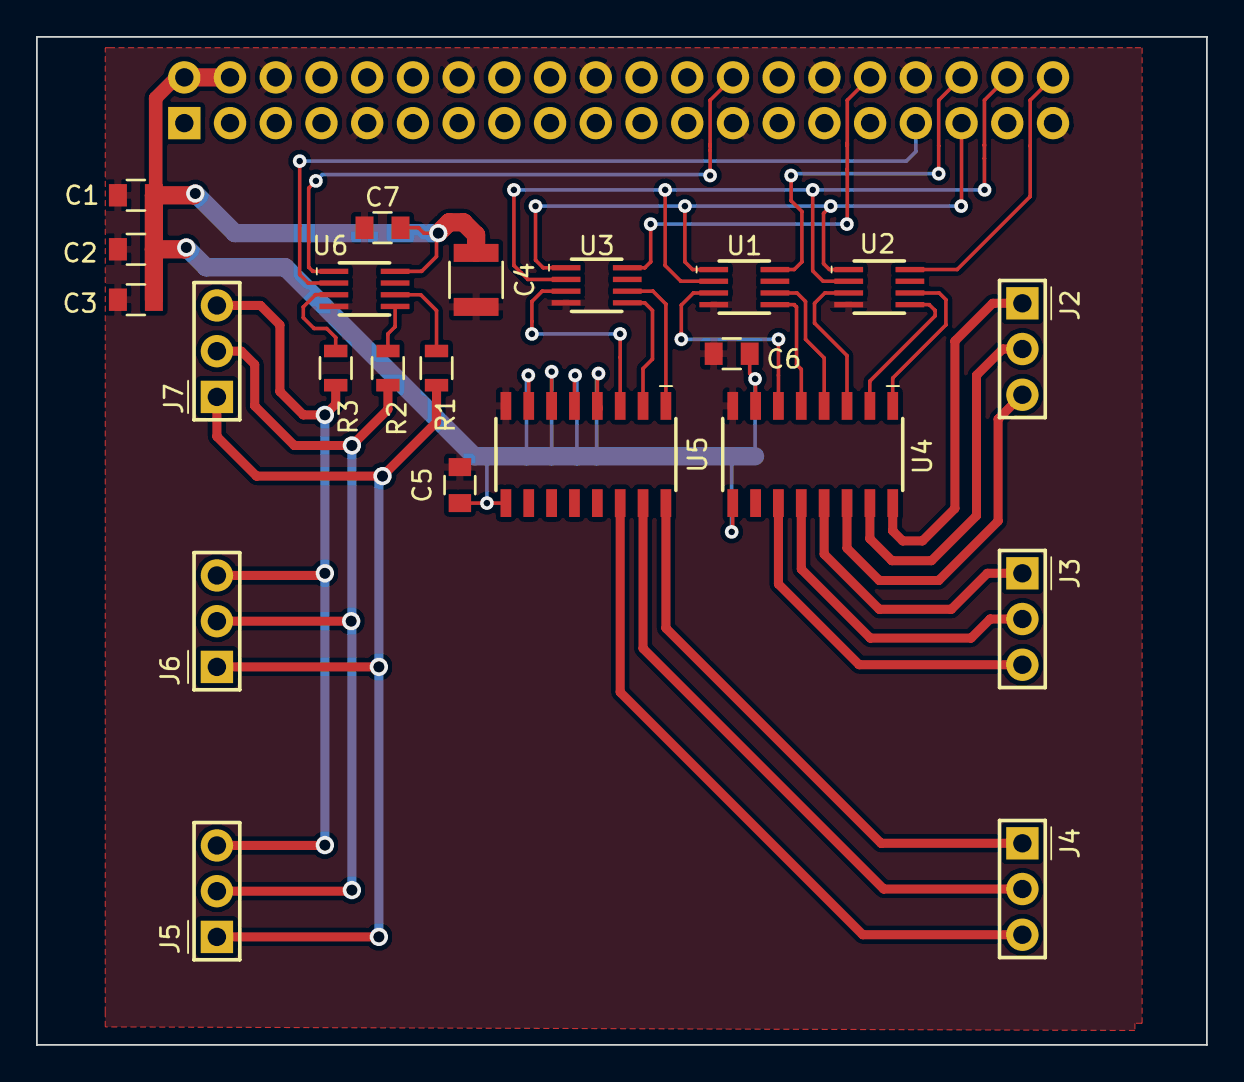
[picture p27: board KiCadDemo.kicad_pcb from above]

Board: 2 copper layers, 65.0 x 56.0 mm, 24 parts (1 on the bottom side), 33 nets.

Other parts of the board:
raspberrypi2_shield: VAL**; raspberrypi2_shield
