DonovanSquires/KiCadDemoExercise/(commit log)

2015-03-18 Schematic, pcb libraries, and netlist created. Also, schematic creation documented with screenshots
    [KiCadDemo.kicad_pcb, KiCadDemo.sch, LEDCubeBufferDemux.sch]
2015-03-19 Mostly finished PCB layout
    [KiCadDemo.sch, LEDCubeBufferDemux.sch]
2015-03-20 Added mounting holes, fixed Raspberry Pi reference footprint mounting hole locations, and removed inaccurate mechanical drawing
    [KiCadDemo.csv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]
2015-03-20 branch to store exercise project, remove mounting holes including libraries
    [KiCadDemo-B_Cu.gbr, KiCadDemo-B_Mask.gbr, KiCadDemo-B_SilkS.gbr, KiCadDemo-Edge_Cuts.gbr, KiCadDemo-F_Cu.gbr, KiCadDemo-F_Mask.gbr, KiCadDemo-F_SilkS.gbr, KiCadDemo.drl]
2015-03-20 Removed SchematicProcedure dir
2015-03-21 deleted inaccurate rpi print, updated system schematic
